kalungagus/EstanteIrrigada-ControleHardware/plots/EstanteIrrigada - PCB.pdf

J9 R³⁶ | R³⁸ R⁷ | R23 U⁷ * | R14 | U9 U⁴ * | J11 1 | 2 | 3 | 4 | 5 | 6 1 | 2 | 3 | 4 | 5 | 6 ABCD | ABCD Size: A4 | Data: 2024-07-13 | Rev: 1 Sheet: 1/1 Título

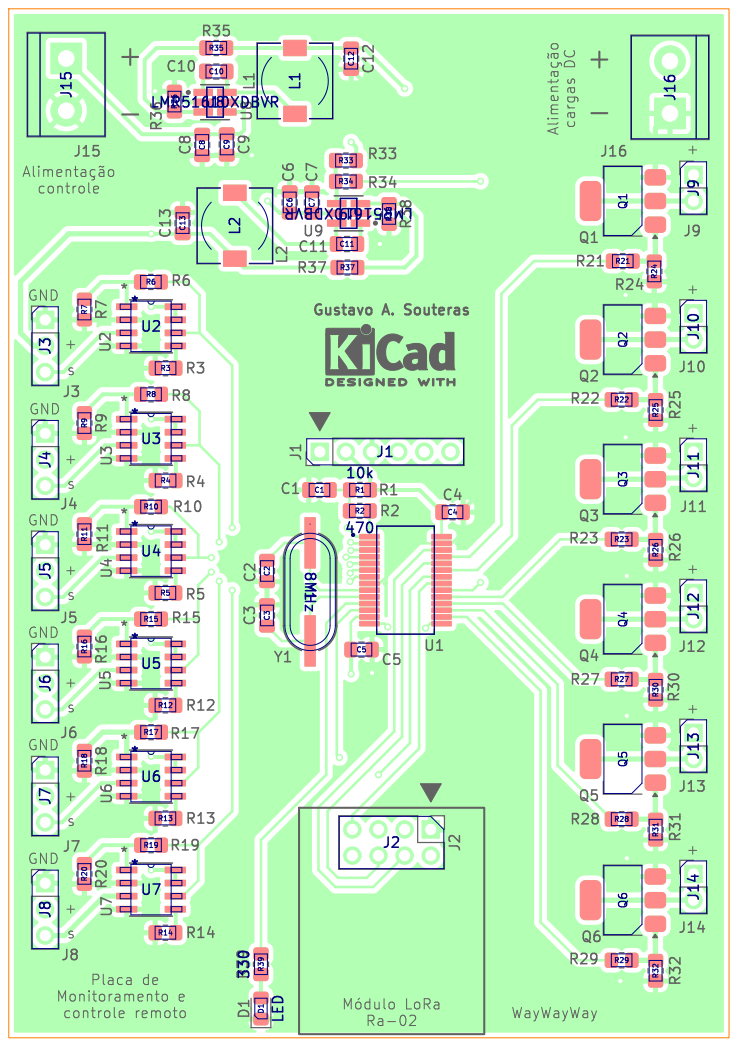
[picture p1: page 1]

Autor: Gustavo Adolpho Souteras Barbosa
