kalungagus/EstanteIrrigada-ControleHardware/EstanteIrrigada.kicad_pcb

## KiCad design EstanteIrrigada.kicad_pcb (2024-08-08)

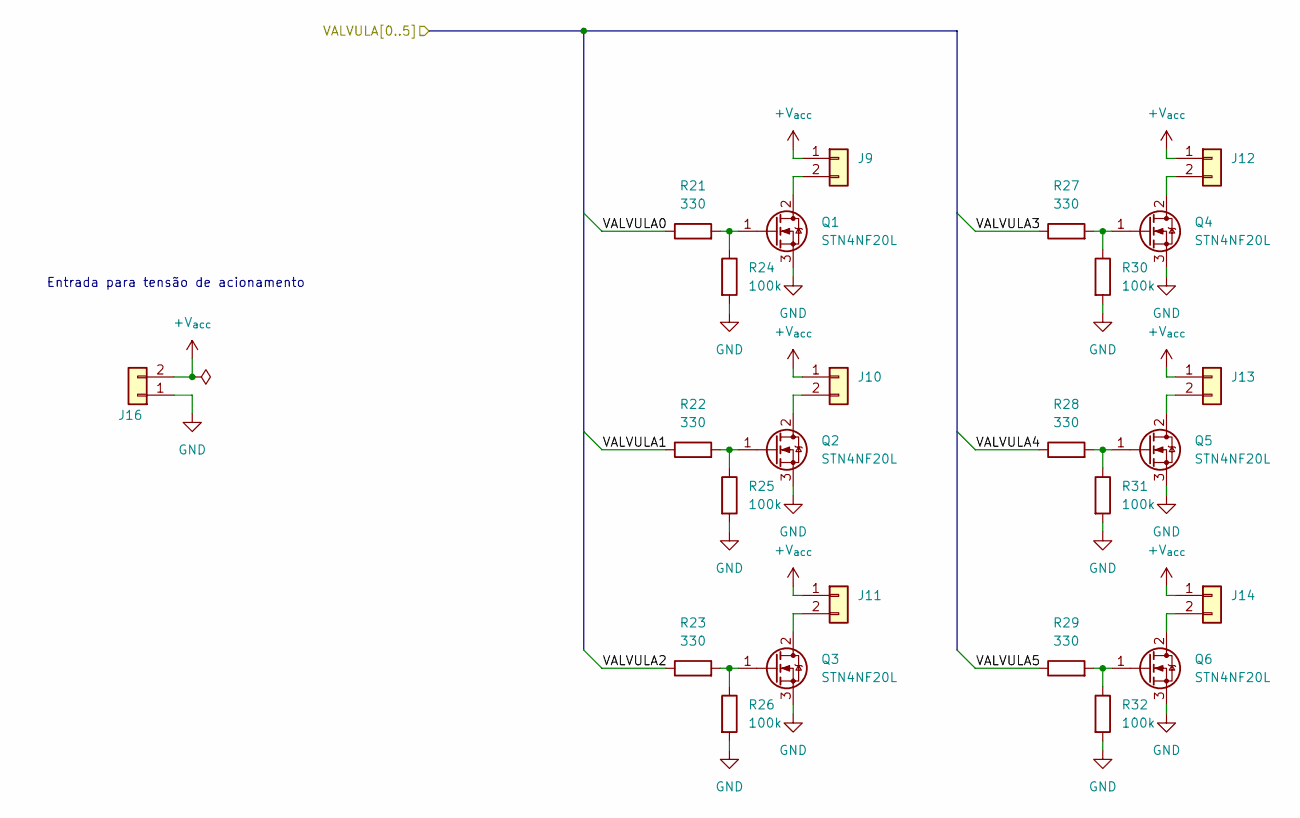
[picture p2: schematic Acionamento.kicad_sch, Estante Irrigada - Controle]

Parts:
J9, J10, J11, J12, J13, J14: Conn_01x02; PinHeader_1x02_P2.54mm_Vertical
J16: Conn_01x02; TerminalBlock_bornier-2_P5.08mm
Q1, Q2, Q3, Q4, Q5, Q6: STN4NF20L; SOT-223-3_TabPin2
R21, R22, R23, R27, R28, R29: 330; R_0805_2012Metric_Pad1.20x1.40mm_HandSolder
R24, R25, R26, R30, R31, R32: 100k; R_0805_2012Metric_Pad1.20x1.40mm_HandSolder

Connections:
+V_{acc}: J9.1, J10.1, J11.1, J12.1, J13.1, J14.1, J16.2
/Acionamento/VALVULA0: R21.1; also elsewhere on the board
/Acionamento/VALVULA1: R22.1; also elsewhere on the board
/Acionamento/VALVULA2: R23.1; also elsewhere on the board
/Acionamento/VALVULA3: R27.1; also elsewhere on the board
/Acionamento/VALVULA4: R28.1; also elsewhere on the board
/Acionamento/VALVULA5: R29.1; also elsewhere on the board
GND: J16.1, Q1.3 (S), Q2.3 (S), Q3.3 (S), Q4.3 (S), Q5.3 (S), Q6.3 (S), R24.2, R25.2, R26.2, R30.2, R31.2, R32.2; also elsewhere on the board
unnamed: J9.2, Q1.2 (D)
unnamed: J10.2, Q2.2 (D)
unnamed: J11.2, Q3.2 (D)
unnamed: J12.2, Q4.2 (D)
unnamed: J13.2, Q5.2 (D)
unnamed: J14.2, Q6.2 (D)
unnamed: Q1.1 (G), R21.2, R24.1
unnamed: Q2.1 (G), R22.2, R25.1
unnamed: Q3.1 (G), R23.2, R26.1
unnamed: Q4.1 (G), R27.2, R30.1
unnamed: Q5.1 (G), R28.2, R31.1
unnamed: Q6.1 (G), R29.2, R32.1

Notes on the sheet:
Entrada para tensão de acionamento

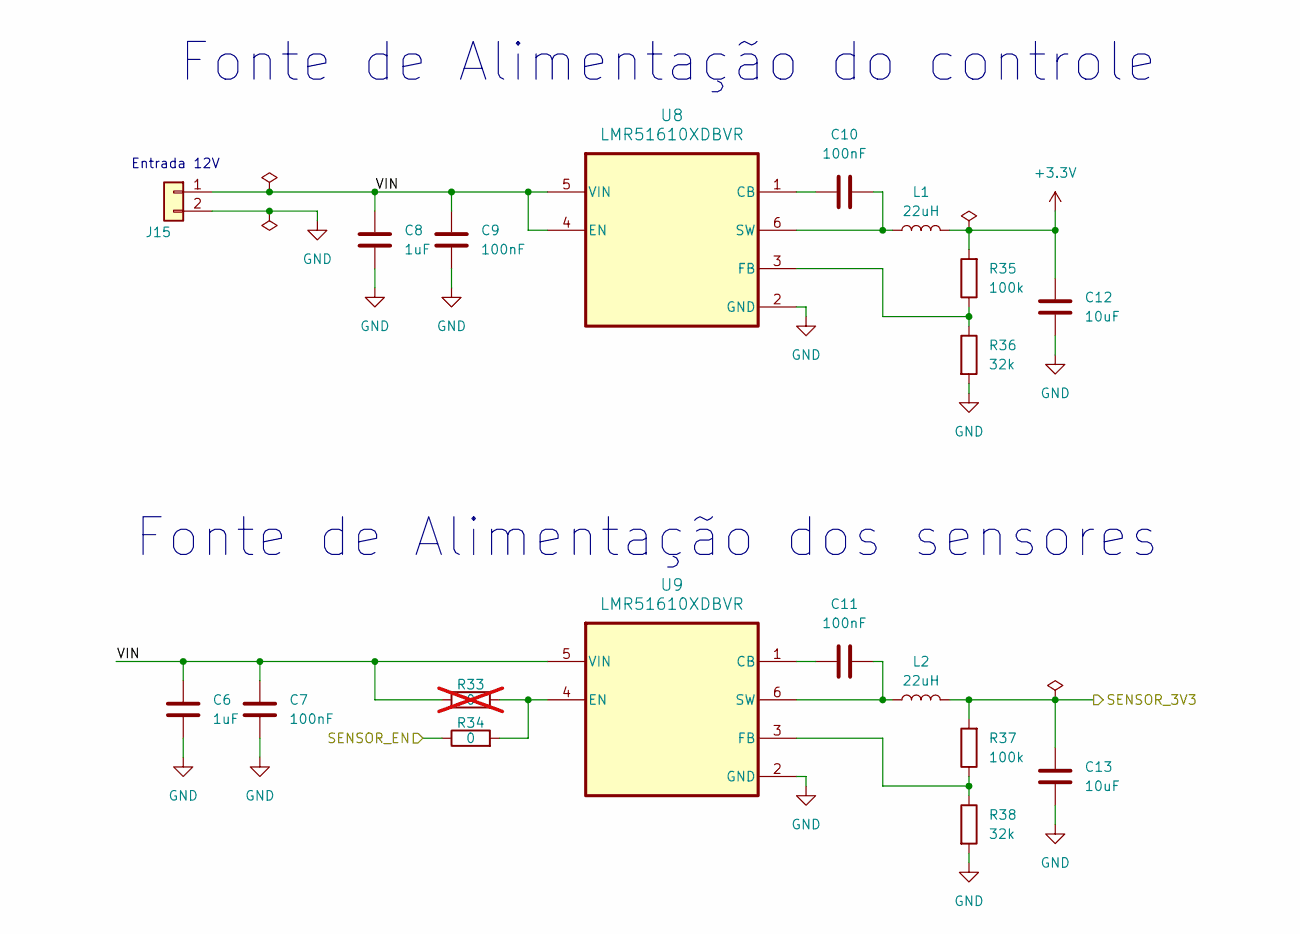
[picture p3: schematic Alimentação.kicad_sch, Estante Irrigada - Controle]

Parts:
C6, C8: 1uF; C_0805_2012Metric_Pad1.18x1.45mm_HandSolder
C7, C9, C10, C11: 100nF; C_0805_2012Metric_Pad1.18x1.45mm_HandSolder
C12, C13: 10uF; C_0805_2012Metric_Pad1.18x1.45mm_HandSolder
J15: Conn_01x02; TerminalBlock_bornier-2_P5.08mm
L1, L2: 22uH; L_7.3x7.3_H3.5
R33: 0; R_0805_2012Metric_Pad1.20x1.40mm_HandSolder; not fitted
R34: 0; R_0805_2012Metric_Pad1.20x1.40mm_HandSolder
R35, R37: 100k; R_0805_2012Metric_Pad1.20x1.40mm_HandSolder
R36, R38: 32k; R_0805_2012Metric_Pad1.20x1.40mm_HandSolder
U8, U9: LMR51610XDBVR; DBV0006A-IPC_A

Connections:
+3.3V: C12.1, L1.2, R35.2; also elsewhere on the board
/Alimentação/SENSOR_3V3: C13.1, L2.2, R37.2; also elsewhere on the board
/Alimentação/SENSOR_EN: R34.1; also elsewhere on the board
/Alimentação/VIN: C6.1, C7.1, C8.1, C9.1, J15.1, R33.1, U8.4 (EN), U8.5 (VIN), U9.5 (VIN)
GND: C6.2, C7.2, C8.2, C9.2, C12.2, C13.2, J15.2, R36.2, R38.2, U8.2 (GND), U9.2 (GND); also elsewhere on the board
unnamed: C10.1, U8.1 (CB)
unnamed: R35.1, R36.1, U8.3 (FB)
unnamed: C10.2, L1.1, U8.6 (SW)
unnamed: C11.1, U9.1 (CB)
unnamed: R33.2, R34.2, U9.4 (EN)
unnamed: R37.1, R38.1, U9.3 (FB)
unnamed: C11.2, L2.1, U9.6 (SW)

Notes on the sheet:
Entrada 12V
Fonte de Alimentação dos sensores
Fonte de Alimentação do controle

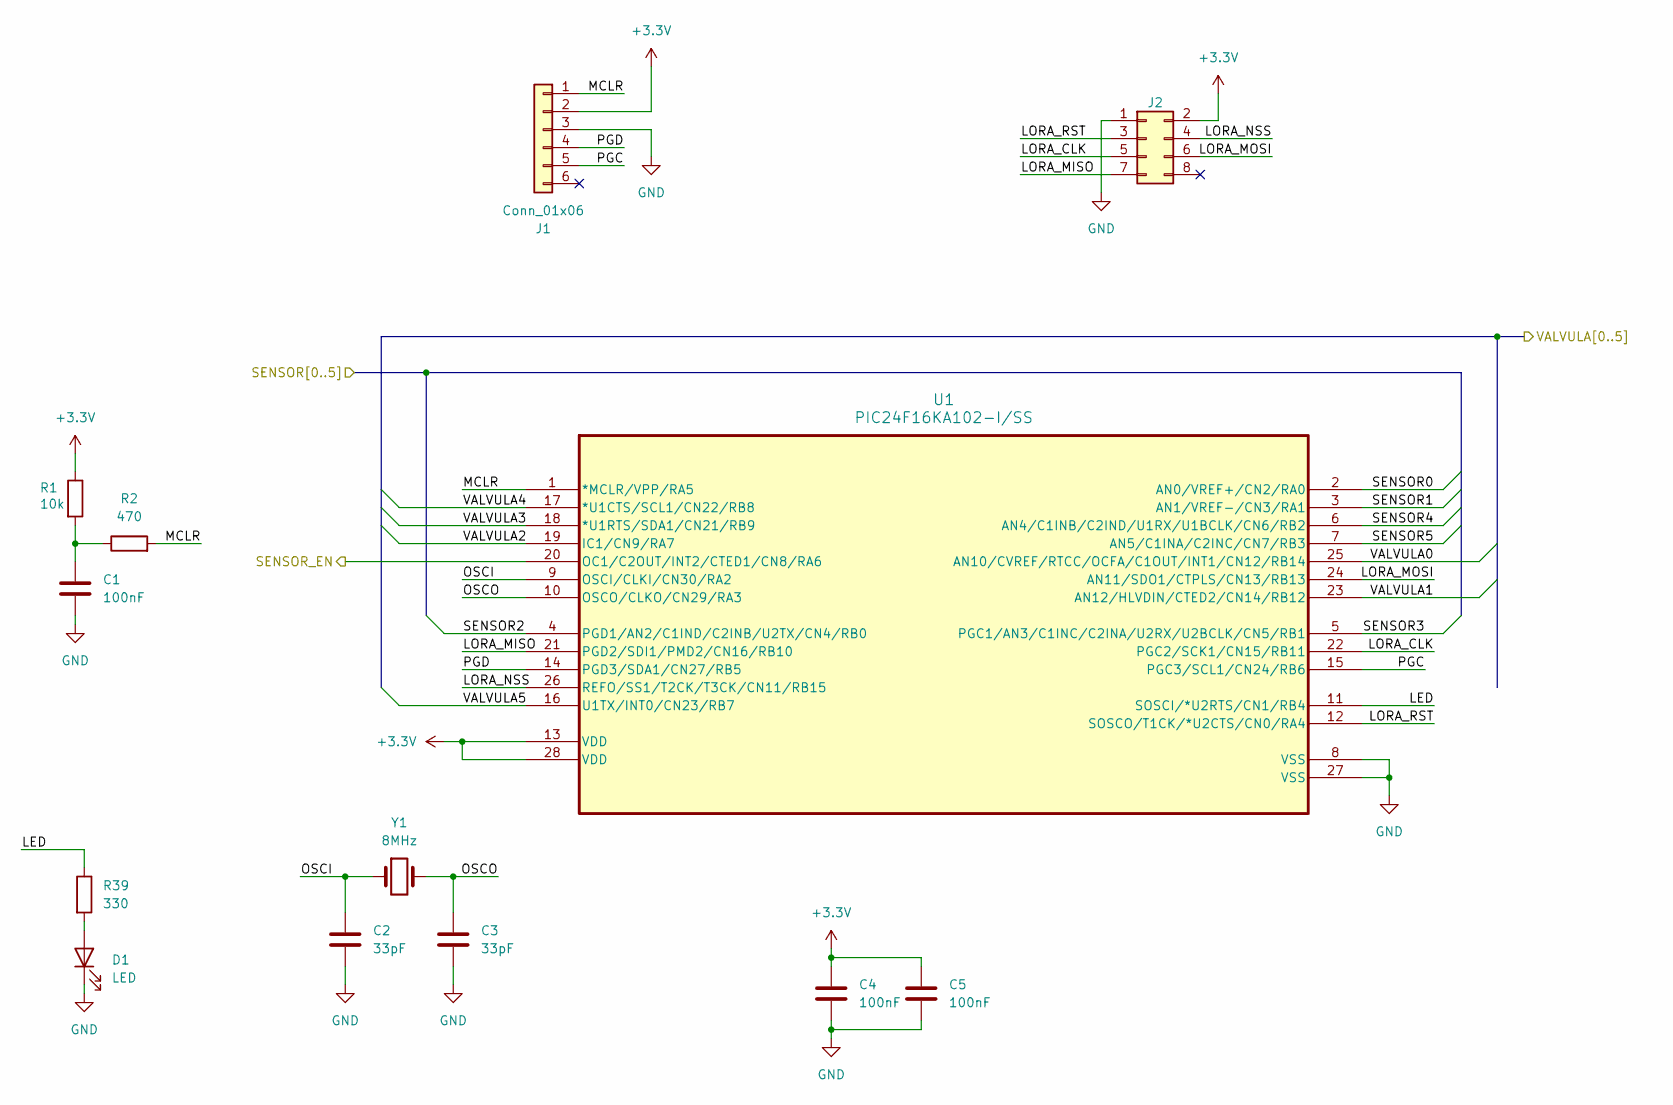
[picture p4: schematic Controle.kicad_sch, Estante Irrigada - Controle]

Parts:
C1, C4, C5: 100nF; C_0805_2012Metric_Pad1.18x1.45mm_HandSolder
C2, C3: 33pF; C_0805_2012Metric_Pad1.18x1.45mm_HandSolder
D1: LED; LED_0805_2012Metric_Pad1.15x1.40mm_HandSolder
J1: Conn_01x06; PinHeader_1x06_P2.54mm_Vertical
J2: Conn_02x04_Odd_Even; PinHeader_2x04_P2.54mm_Vertical
R1: 10k; R_0805_2012Metric_Pad1.20x1.40mm_HandSolder
R2: 470; R_0805_2012Metric_Pad1.20x1.40mm_HandSolder
R39: 330; R_0805_2012Metric_Pad1.20x1.40mm_HandSolder
U1: PIC24F16KA102-I/SS; SOP65P780X200-28N
Y1: 8MHz; HC-49&slash_US_11P4X3P8_IQD

Connections:
+3.3V: C4.1, C5.1, J1.2, J2.2, R1.1, U1.13 (VDD), U1.28 (VDD); also elsewhere on the board
/Acionamento/VALVULA0: U1.25 (AN10/CVREF/RTCC/OCFA/C1OUT/INT1/CN12/RB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); also elsewhere on the board
/Acionamento/VALVULA1: U1.23 (AN12/HLVDIN/CTED2/CN14/RB12); also elsewhere on the board
/Acionamento/VALVULA2: U1.19 (IC1/CN9/RA7); also elsewhere on the board
/Acionamento/VALVULA3: U1.18 (*U1RTS/SDA1/CN21/RB9); also elsewhere on the board
/Acionamento/VALVULA4: U1.17 (*U1CTS/SCL1/CN22/RB8); also elsewhere on the board
/Acionamento/VALVULA5: U1.16 (U1TX/INT0/CN23/RB7); also elsewhere on the board
/Alimentação/SENSOR_EN: U1.20 (OC1/C2OUT/INT2/CTED1/CN8/RA6); also elsewhere on the board
/Controle/LED: R39.1, U1.11 (SOSCI/*U2RTS/CN1/RB4)
/Controle/LORA_CLK: J2.5, U1.22 (PGC2/SCK1/CN15/RB11)
/Controle/LORA_MISO: J2.7, U1.21 (PGD2/SDI1/PMD2/CN16/RB10)
/Controle/LORA_MOSI: J2.6, U1.24 (AN11/SDO1/CTPLS/CN13/RB13)
/Controle/LORA_NSS: J2.4, U1.26 (REFO/SS1/T2CK/T3CK/CN11/RB15)
/Controle/LORA_RST: J2.3, U1.12 (SOSCO/T1CK/*U2CTS/CN0/RA4)
/Controle/MCLR: J1.1, R2.2, U1.1 (*MCLR/VPP/RA5)
/Controle/OSCI: C2.1, U1.9 (OSCI/CLKI/CN30/RA2), Y1.1
/Controle/OSCO: C3.1, U1.10 (OSCO/CLKO/CN29/RA3), Y1.2
/Controle/PGC: J1.5, U1.15 (PGC3/SCL1/CN24/RB6)
/Controle/PGD: J1.4, U1.14 (PGD3/SDA1/CN27/RB5)
/Controle/SENSOR0: U1.2 (AN0/VREF+/CN2/RA0); also elsewhere on the board
/Controle/SENSOR1: U1.3 (AN1/VREF-/CN3/RA1); also elsewhere on the board
/Controle/SENSOR2: U1.4 (PGD1/AN2/C1IND/C2INB/U2TX/CN4/RB0); also elsewhere on the board
/Controle/SENSOR3: U1.5 (PGC1/AN3/C1INC/C2INA/U2RX/U2BCLK/CN5/RB1); also elsewhere on the board
/Controle/SENSOR4: U1.6 (AN4/C1INB/C2IND/U1RX/U1BCLK/CN6/RB2); also elsewhere on the board
/Controle/SENSOR5: U1.7 (AN5/C1INA/C2INC/CN7/RB3); also elsewhere on the board
GND: C1.2, C2.2, C3.2, C4.2, C5.2, D1.1 (K), J1.3, J2.1, U1.8 (VSS), U1.27 (VSS); also elsewhere on the board
unnamed: C1.1, R1.2, R2.1
unnamed: D1.2 (A), R39.2

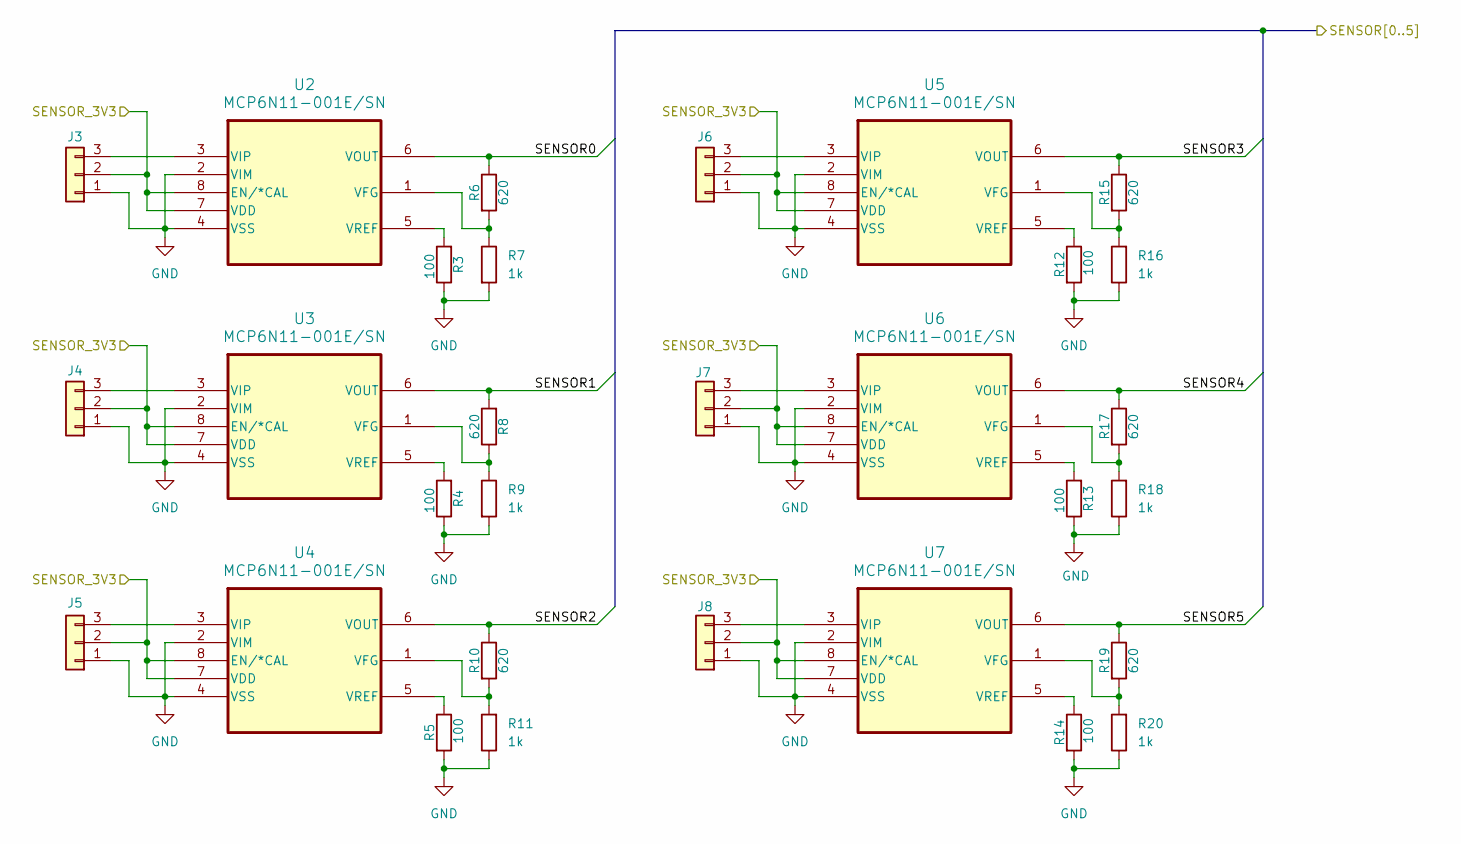
[picture p5: schematic Sensores.kicad_sch, Estante Irrigada - Controle]

Parts:
J3, J4, J5, J6, J7, J8: Conn_01x03; PinHeader_1x03_P2.54mm_Vertical
R3, R4, R5, R12, R13, R14: 100; R_0805_2012Metric_Pad1.20x1.40mm_HandSolder
R6, R8, R10, R15, R17, R19: 620; R_0805_2012Metric_Pad1.20x1.40mm_HandSolder
R7, R9, R11, R16, R18, R20: 1k; R_0805_2012Metric_Pad1.20x1.40mm_HandSolder
U2, U3, U4, U5, U6, U7: MCP6N11-001E/SN; SOIC8-N_MC_MCH

Connections:
/Alimentação/SENSOR_3V3: J3.2, J4.2, J5.2, J6.2, J7.2, J8.2, U2.7 (VDD), U2.8 (EN/*CAL), U3.7 (VDD), U3.8 (EN/*CAL), U4.7 (VDD), U4.8 (EN/*CAL), U5.7 (VDD), U5.8 (EN/*CAL), U6.7 (VDD), U6.8 (EN/*CAL), U7.7 (VDD), U7.8 (EN/*CAL); also elsewhere on the board
/Controle/SENSOR0: R6.1, U2.6 (VOUT); also elsewhere on the board
/Controle/SENSOR1: R8.2, U3.6 (VOUT); also elsewhere on the board
/Controle/SENSOR2: R10.1, U4.6 (VOUT); also elsewhere on the board
/Controle/SENSOR3: R15.1, U5.6 (VOUT); also elsewhere on the board
/Controle/SENSOR4: R17.1, U6.6 (VOUT); also elsewhere on the board
/Controle/SENSOR5: R19.1, U7.6 (VOUT); also elsewhere on the board
GND: J3.1, J4.1, J5.1, J6.1, J7.1, J8.1, R3.1, R4.1, R5.2, R7.2, R9.2, R11.1, R12.2, R13.1, R14.2, R16.1, R18.1, R20.1, U2.2 (VIM), U2.4 (VSS), U3.2 (VIM), U3.4 (VSS), U4.2 (VIM), U4.4 (VSS), U5.2 (VIM), U5.4 (VSS), U6.2 (VIM), U6.4 (VSS), U7.2 (VIM), U7.4 (VSS); also elsewhere on the board
unnamed: J3.3, U2.3 (VIP)
unnamed: J4.3, U3.3 (VIP)
unnamed: J5.3, U4.3 (VIP)
unnamed: J6.3, U5.3 (VIP)
unnamed: J7.3, U6.3 (VIP)
unnamed: J8.3, U7.3 (VIP)
unnamed: R6.2, R7.1, U2.1 (VFG)
unnamed: R3.2, U2.5 (VREF)
unnamed: R8.1, R9.1, U3.1 (VFG)
unnamed: R4.2, U3.5 (VREF)
unnamed: R10.2, R11.2, U4.1 (VFG)
unnamed: R5.1, U4.5 (VREF)
unnamed: R15.2, R16.2, U5.1 (VFG)
unnamed: R12.1, U5.5 (VREF)
unnamed: R17.2, R18.2, U6.1 (VFG)
unnamed: R13.2, U6.5 (VREF)
unnamed: R19.2, R20.2, U7.1 (VFG)
unnamed: R14.1, U7.5 (VREF)

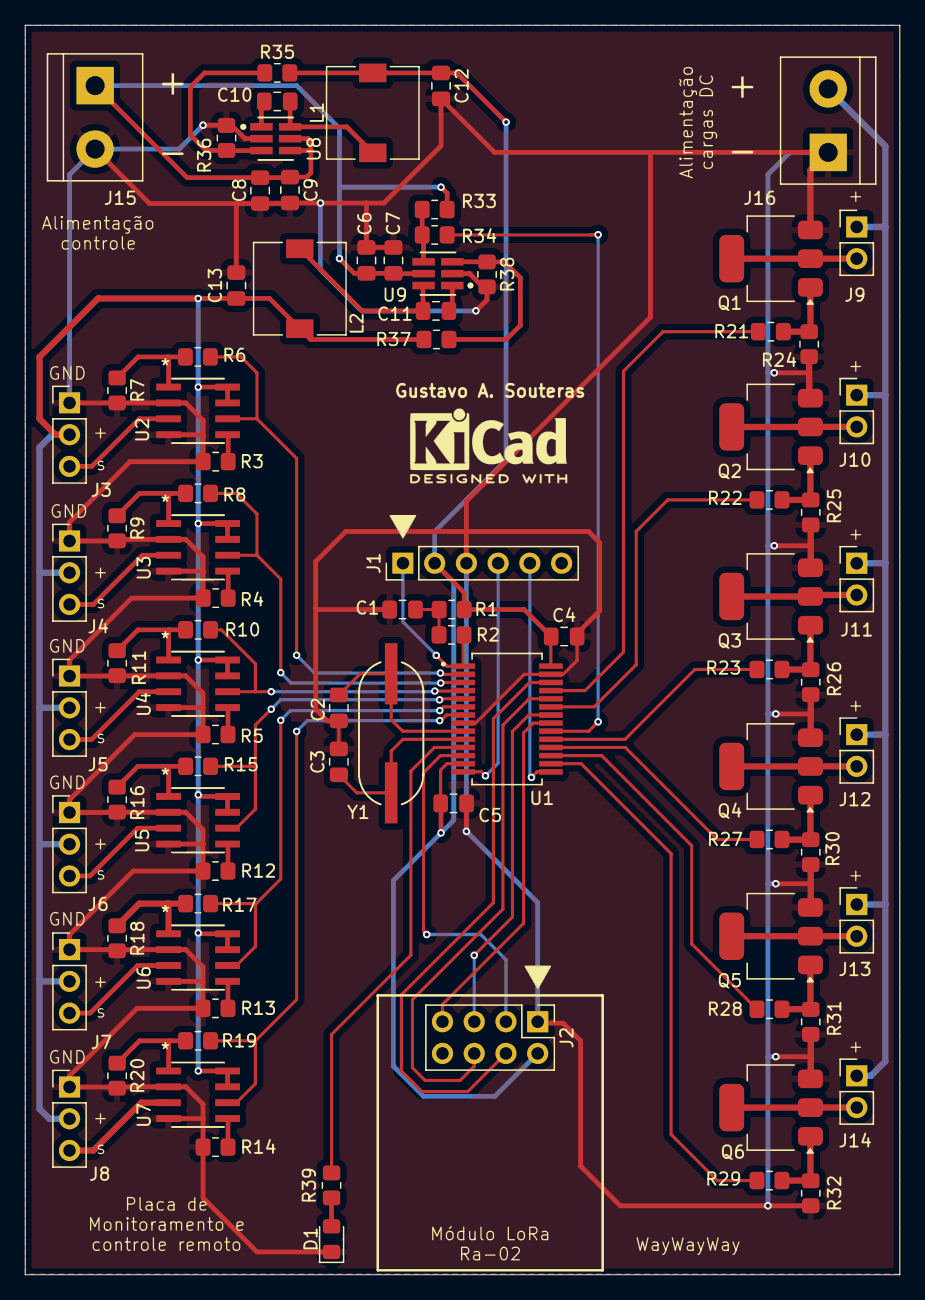
[picture p6: board EstanteIrrigada.kicad_pcb from above]

Board: 2 copper layers, 70.0 x 100.0 mm, 87 parts (0 on the bottom side), 68 nets.
